MarthNotMirthun/asv-project-May_2026/lichifit_thruster.png

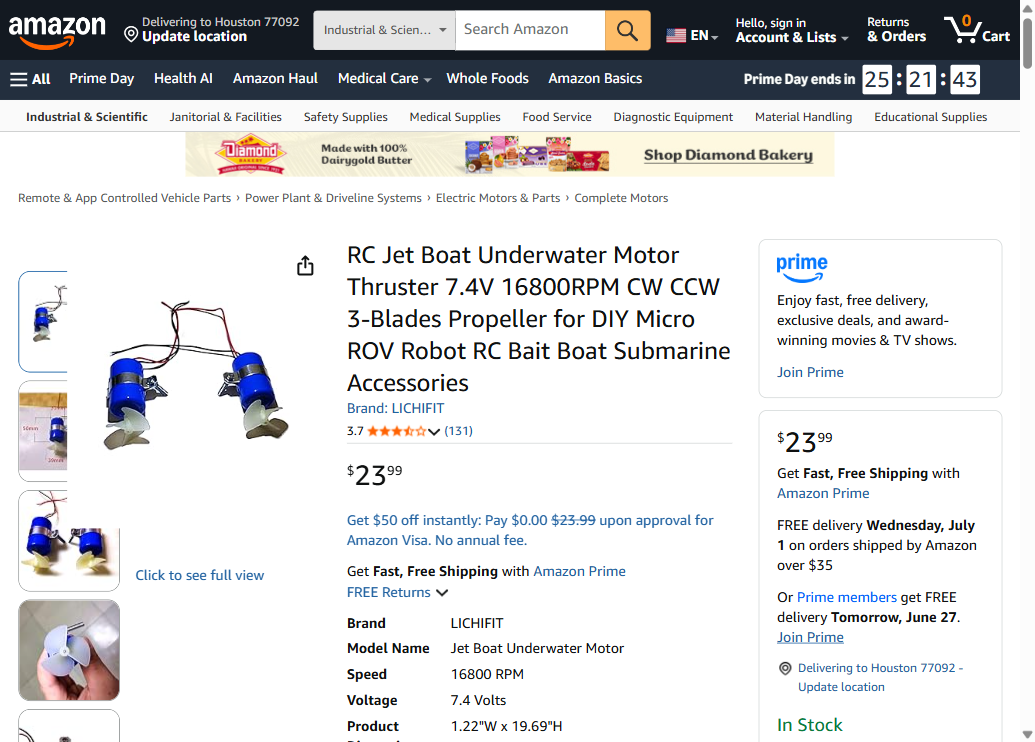
lichifit_thruster.png
