MarthNotMirthun/asv-project-May_2026/enclosure_b0dx781z3w.png

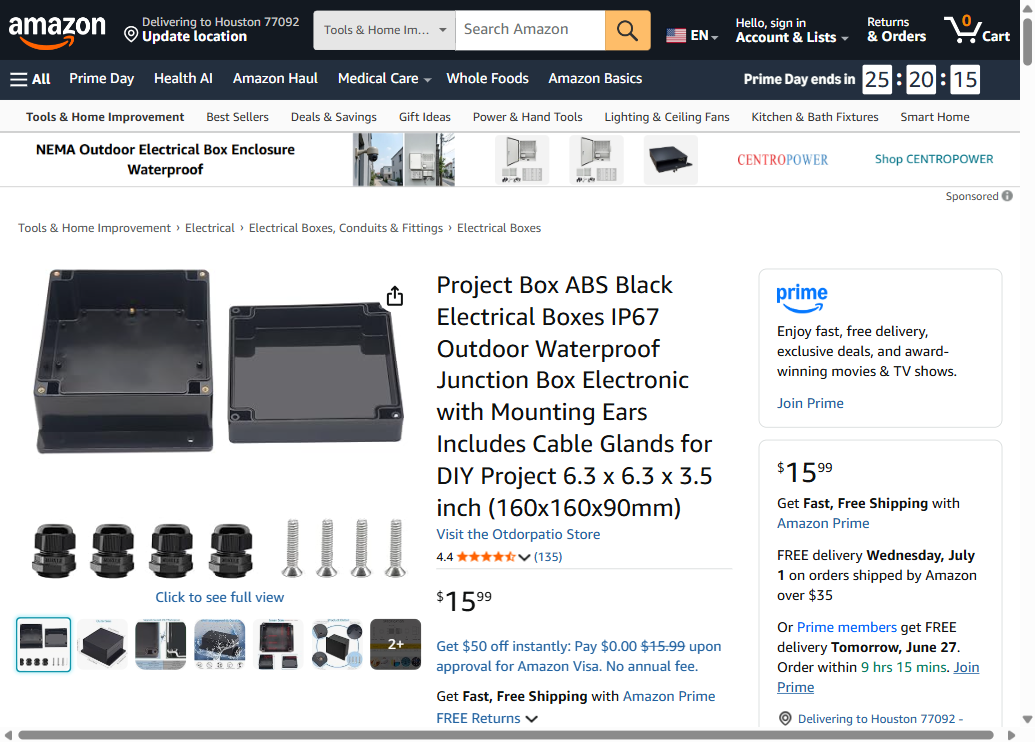
enclosure_b0dx781z3w.png
