MarthNotMirthun/asv-project-May_2026/irlz44n_search.png

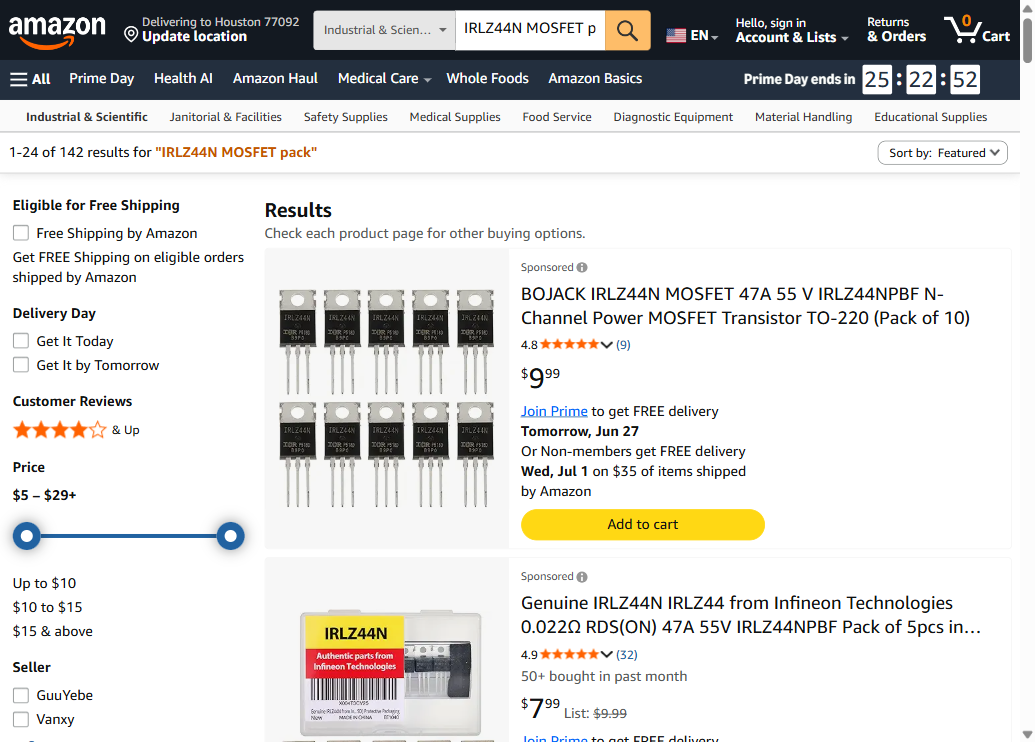
irlz44n_search.png
