MarthNotMirthun/asv-project-May_2026/mcp6022_amazon.png

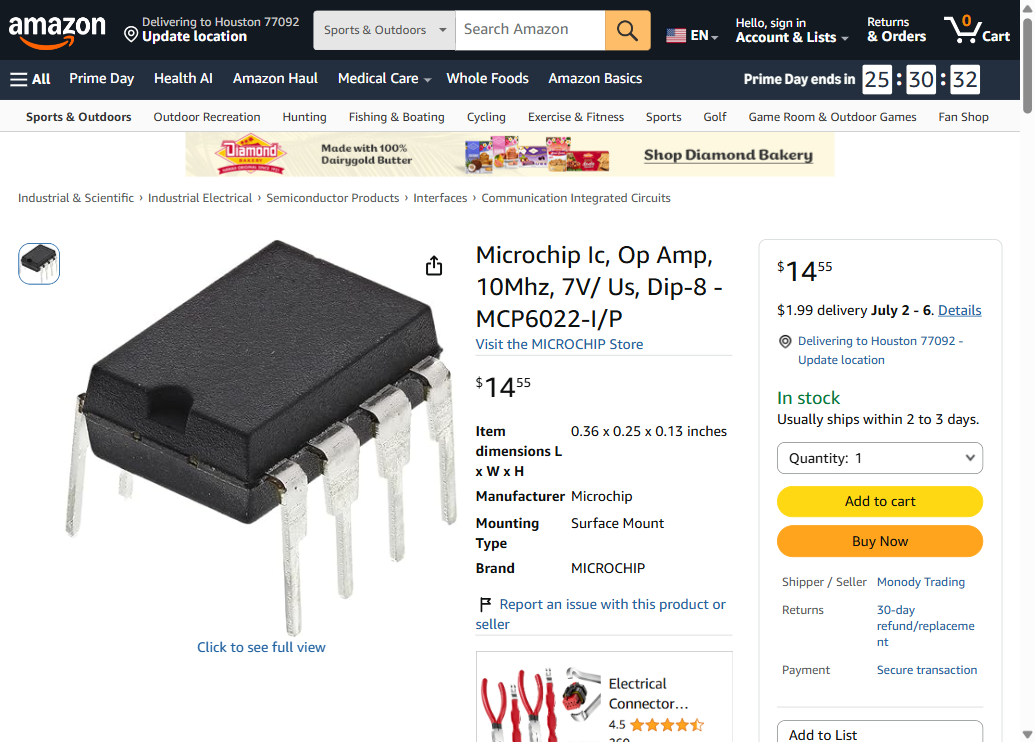
mcp6022_amazon.png
