MarthNotMirthun/asv-project-May_2026/mcp6022_prime.png

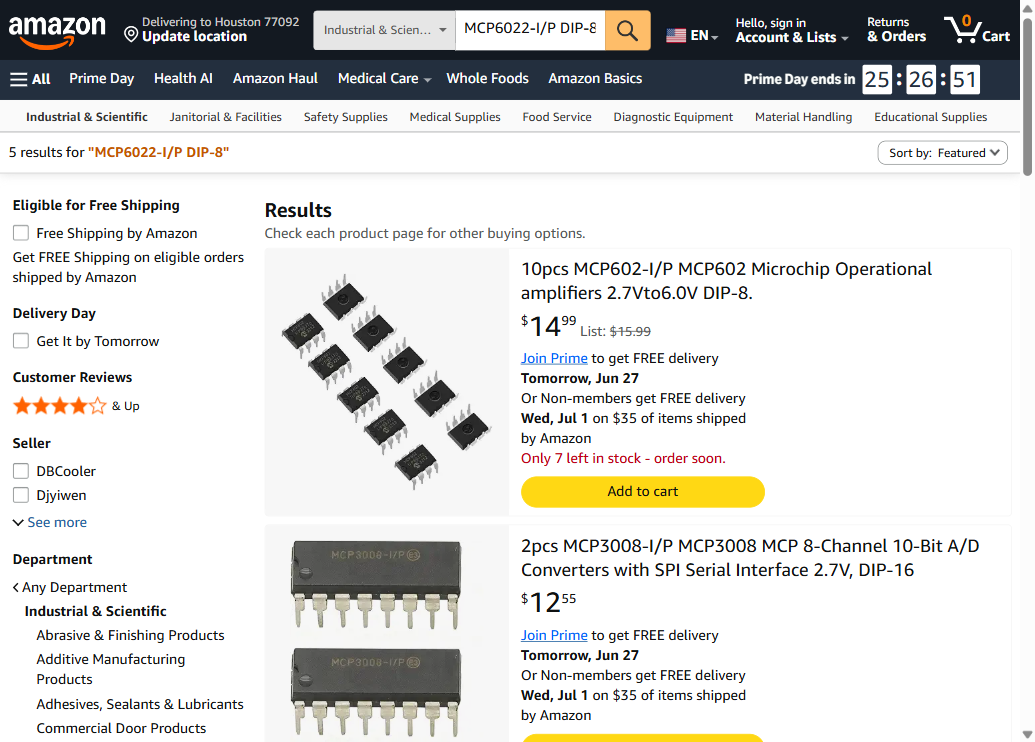
mcp6022_prime.png
