MarthNotMirthun/asv-project-May_2026/mcp6022_search2.png

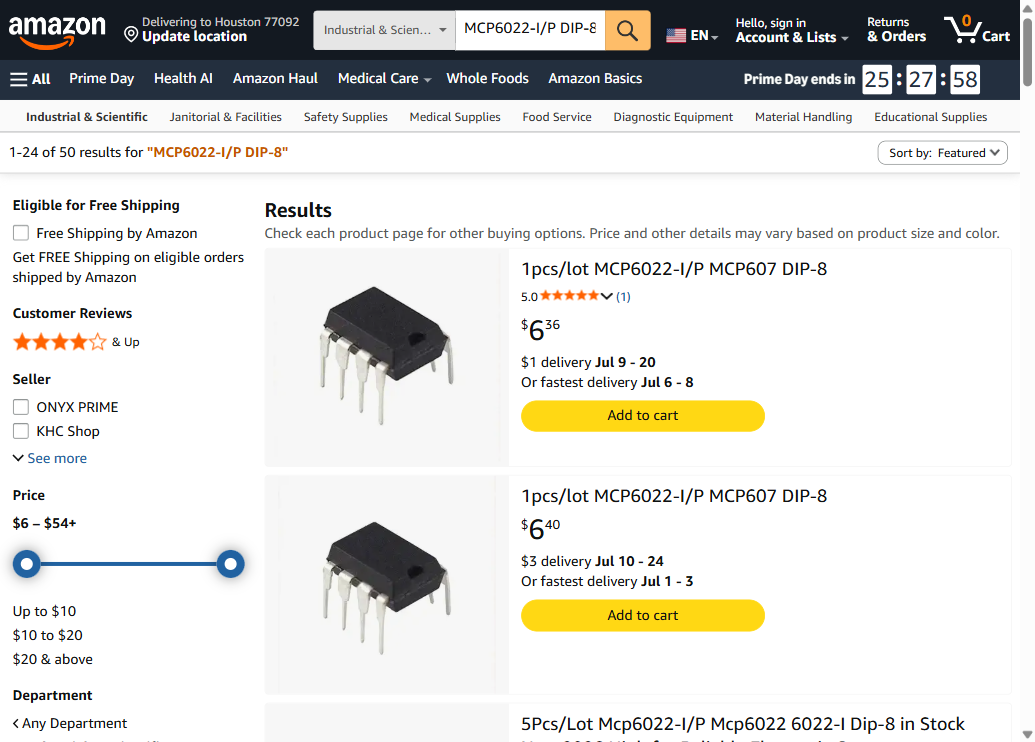
mcp6022_search2.png
