MarthNotMirthun/asv-project-May_2026/mcp6022_search.png

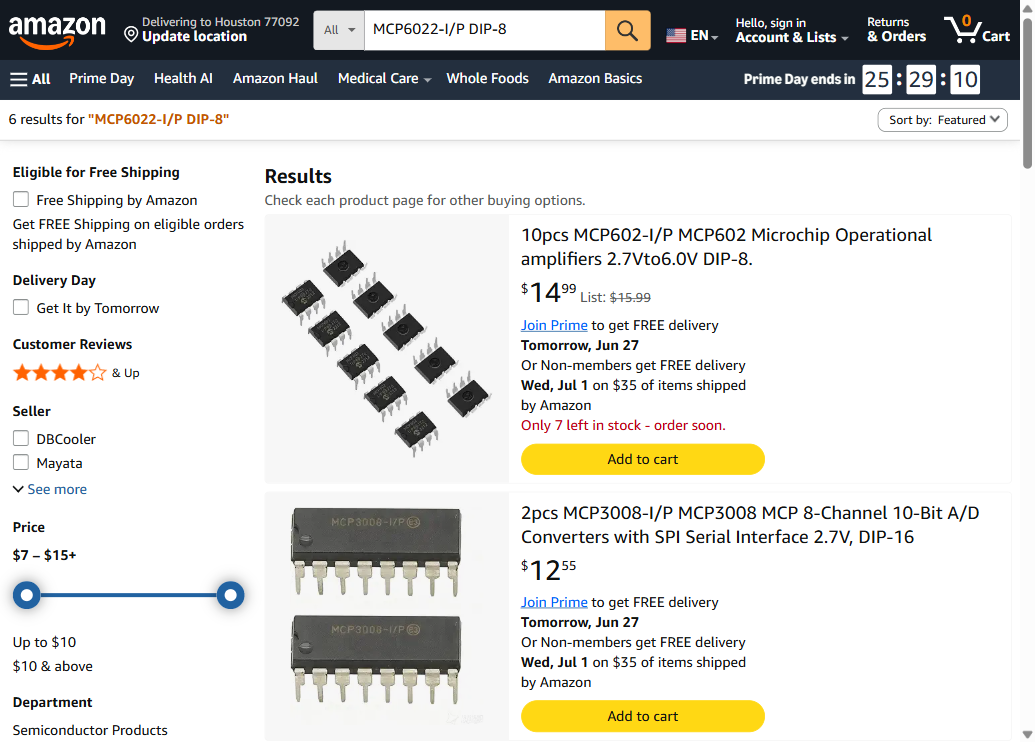
mcp6022_search.png
