MarthNotMirthun/asv-project-May_2026/(commit log)

2026-06-10 Fix uart_tx.cst: clk pin PULL_MODE UP->NONE (clock input needs no pull resistor)
2026-06-10 Fix FIR banks: replace initial blocks with synthesizable case-statement ROM; add fir_test_top timing wrapper
    [fir_filter_bank1.v, fir_filter_bank2.v]
2026-06-13 Week 3: FPGA pipeline verified - uart_tx, ADC, CIC, dual FIR banks
2026-06-16 Week 4: FC-5/FC-6 resolved - SNR-gradient ranging architecture, CLAUDE.md aligned
    - TRAJECTORY.md: Add CQ-1 (SNR plateau calibration queue); update Section 1 blocker
    note (FC-5/FC-6 confirmed resolved); update Section 4 matched filter spec to
    2109-sample 5ms reference chirps, corr_peak/snr as primary outputs, peak_lag
    diagnostic only
    - CLAUDE.md: Remove ToF/range_cm language from pipeline spec; update correlation
    window to 421,875 SPS (FC-3); rename [range_cm] packet bytes to [peak_lag]
    (wire format unchanged); update ROS topic /acoustic/range_m -> /acoustic/corr_snr;
    HOMING uses SNR gradient ascent; ARRIVED uses SNR_ARRIVED_THRESHOLD (CQ-1);
    Week 4 current, immediate tasks upd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
2026-06-16 Week 4: Dual matched filter correlators - SNR-gradient architecture per FC-5/FC-6
    - matched_filter_1.v: 34-38 kHz block correlator, 2109-tap, 48-bit accumulator
    - matched_filter_2.v: 42-46 kHz block correlator, identical architecture
    - Both: OTR window-OR (FC-2), CORR_SHIFT=16 scaling contract, 200Hz output
    - Testbenches: CHIRP_DETECT/NOISE_REJECT/OTR_FLAG/NO_XZ/SCALING/PEAK_LAG_ZERO all PASS
    - CLAUDE.md: corrected 800->2109 samples, 32/48->~4-6/48 HW mult, BSRAM totals
    - docs/progress.md: pipeline run logged with resource totals and latency
    [matched_filter_1.v, matched_filter_2.v, tb_matched_filter_1.v, tb_matched_filter_2.v]
2026-06-16 Week 4: Correct BSRAM resource accounting - depth constraint not capacity (12 blocks not 8, ~30% running total)
    - Depth constraint is binding: 1K×18 mode = 1024 locations/block
    2×1024=2048 < 2109 samples → 3 blocks per array, not 2
    - Corrected per-channel: 6 blocks (3 ref ROM + 3 window buffer)
    - Corrected total matched filter: 12 blocks (not 6 or 8)
    - Running total with FIR coefficients: ~14/46 blocks (~30%, not ~17%)
    - matched_filter_1.v, matched_filter_2.v: header comments corrected
    - CLAUDE.md: BSRAM table corrected; 4-array architecture documented
    - docs/progress.md: correction and forward budget outlook logged
    [matched_filter_1.v, matched_filter_2.v]
2026-06-17 Week 4: Layer A bench plan validated - two architecture blockers found (transducer bandwidth, MAX9814 audio-only)
    hw-validation confirmed FPGA PWM tone source is viable (FPGA clock divider
    exact to <0.15% at 40/36/44kHz). Two project-level blockers discovered:
    TCT40-16T/R are 40kHz-narrowband resonators - 34-38kHz and 42-46kHz chirp
    bands sit off-resonance. MAX9814 is a 20kHz audio preamp - cannot pass 40kHz.
    TRAJECTORY.md DL-1 updated with validated drive circuit specs and both blockers.
2026-06-17 Thruster downgrade 545 -> RF-370 (LICHIFIT): L298N-safe, add thrust gate
    545-class (~3.6A) structurally exceeds purchased L298N (2A/3A). Switch to
    LICHIFIT RF-370 kit (stall <1.8A, L298N PASS), drive ~9V via PWM duty cap,
    buy 2 kits (~$48) for spare-pair hedge. Add DL-2 with thrust-to-weight
    assessment and a gate: bench-verify >=150g/motor (200g target) before any
    thruster is epoxied into the hull (Week 5/6 boundary, pre-Week-6 mounting).
2026-06-17 Add PWM duty cycle ceiling requirement to hardware and firmware specs.
    Firmware must enforce 80% PWM max to protect thrusters from over-voltage due to
    L298N ~2V drop: at full duty cycle the 11.1V LiPo delivers ~9V effective,
    while at 80% the thrusters see ~9V safely. Baked this requirement into:
    - ESP32 #1 section (hardware constraint)
    - motor_driver_node spec (scaling requirement)
    - Week 6 timeline task
    - LOCKED DECISIONS table (design decision)
    This is NOT optional tuning — it is a firmware hard cap that must be enforced.
2026-06-18 Week 4: FC-7 confirmed (dual-channel gating mandatory), FC-8 added (egress maneuver), preamp AGC disqualification documented
    - FC-7: Added mandatory dual-channel gating specification (symmetric thresholding) to prevent false Buoy 2 detection during ARRIVED_1→SCAN_2 transition when cross-talk is +15 to +21 dB above genuine signal
    - FC-7: Unblocked peak_detector.v — now ready to build with dual-channel gating logic
    - FC-8 (NEW): Egress maneuver required after each ARRIVED_N state before starting SCAN_(N+1) to reduce vehicle-to-previous-buoy distance below dual-channel isolation margin
    - Preamp Hardware Contract: Replaced MAX9814 spec with mandatory fixed-gain op-amp contract; MAX9814 disqu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
2026-06-18 Week 4: peak_detector + packet_framer VALIDATED, docs updated - FC-7/FC-8 locked, pipeline status current
    peak_detector.v and packet_framer.v both verified with 12/12 sim checks passing.
    - Dual-channel RELATIVE gating (FC-7) confirmed superior to absolute thresholding
    - SNR proxy (8-bit), corr_peak (32-bit), peak_lag diagnostic (11-bit) outputs
    - 8-byte FSM packet format: [target_id][peak_lag_H/L][corr_peak_H/L][snr][XOR checksum][0xFF]
    - Commit hash 7ee44f0
    Architecture locked:
    - FC-7: Code-division beacon ID by sweep direction (up/down) in shared 38.5–41.5 kHz passband
    - FC-8: Egress maneuver required after each ARRIVED state for separation
    Next: FIR coefficient re-spin to 38.5–41.5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
2026-06-18 Week 4: FIR banks VALIDATED at 38.5-41.5kHz - all 9 FPGA modules verified, pipeline integration unblocked
    FIR Filter Banks (Jun 18):
    - Both fir_filter_bank1.v and fir_filter_bank2.v re-spun to 38.5-41.5 kHz passband per FC-7
    - Coefficients updated for single shared 40 kHz center frequency, 3 kHz bandwidth
    - Code-division beacon ID via sweep direction (up vs down), not frequency bands
    - 32-tap Hamming windowed-sinc, passband ripple <1dB, stopband confirmed
    - verilog-sim-runner: ALL PASS, no X/Z states
    Pipeline Status (all 9 modules):
    ✅ uart_tx (Jun 8)
    ✅ adc_interface (Jun 13)
    ✅ cic_decimator (Jun 10)
    ✅ fir_filter_bank1 (Jun 18)
    ✅ fir_filter_bank2 (Jun 18)
    ✅ matched_filter_1 (Jun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
2026-06-26 Week 5: Component audit firmware requirements and hardware build notes added
    - motor_driver_node: mandatory stall-current protection (cut PWM if >1.5A/ch for >100ms,
    resume at 50% after 500ms) — LICHIFIT RF-370 stall = 5-8.6A, destroys L298N at sustained stall
    - ESP32 ENA/ENB: must use LEDC hardware PWM channels (GPIO25/26), not GPIO toggle; software
    toggle can slip above 80% duty under micro-ROS + IMU + ultrasonic interrupt pressure
    - collision_safety_node: ESTOP threshold raised 25cm -> 30cm; JSN-SR04T blind zone is 25cm,
    25cm threshold risks missing obstacles in sensor dead zone
    - Preamp gain: revised to x100 / 40dB (Rf=9.1kΩ or 10kΩ, Rg=1kΩ per stage); x196 clips
    ADC at 5.1m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
2026-06-29 Week 5 close / Week 6 start: definitive component audit complete, timeline revised for 43-day sprint to August 10 demo
    - docs/component_audit_june28.md: full signal chain audit with datasheet citations; MCP6022 confirmed over MCP6002 (GBW math), IRLZ44N verified at 40kHz switching, enclosure B0DX781Z3W 160x160x90mm confirmed, TCT40-16T/R bandwidth conditional on Layer A bench sweep
    - docs/TRAJECTORY.md: Section 4 replaced with revised 6-week plan (Weeks 6-11); DL-5 added (MCP6022-I/P selected, full rolloff math); Week 6 day-by-day breakdown
    - CLAUDE.md: status updated to Week 5 CLOSED / Week 6 starts Jun 29; In Transit populated (LICHIFIT x2, enclosure, IRLZ44N); Not Yet Ordered updated with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
2026-06-30 Week 6: Top-level pipeline integration complete
    Wire all 9 verified FPGA modules into top_level.v: adc_interface ->
    cic_decimator -> fir_filter_bank1/2 (parallel) -> matched_filter_1/2
    (parallel) -> peak_detector -> packet_framer -> uart_tx.
    Fix packet_framer corr_peak packing (FIX-B3): was sending raw [15:0]
    which wraps and inverts the FC-6 homing gradient at close range; now
    sends saturating (corr_peak>>6) clamped to 16-bit, preserving
    monotonic SNR gradient through final approach.
    Add top_level.cst merged constraint file covering all external pins.
    Write tb_top_level.v end-to-end testbench (synthetic 40kHz chirp).
    Full pipeline sim: ALL PASS — 8-byte UART packet decoded, checksum
    veri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
    [matched_filter_1.v, matched_filter_2.v, packet_framer.v, tb_top_level.v, top_level.v]
2026-06-30 Week 6: ESP32 vehicle firmware skeleton
    micro-ROS node for the ASV vehicle controller (ESP32 #1):
    - MPU-6050 I2C driver (GPIO21/22), publishes /imu/data at 100Hz
    - L298N motor control via LEDC PWM GPIO25/26 (ENA/ENB),
    subscribes /cmd_vel Twist, enforces 80% duty cap (DL-1)
    - JSN-SR04T sonar (30cm ESTOP, 1-second clear hysteresis),
    publishes /collision/range_cm at 10Hz
    - Stall protection: software current estimate >1.5A for >100ms
    cuts PWM to 0, resumes at 50% after 500ms (DL-4)
    - cmd_vel watchdog: zero motors if no command for >500ms
    - RELIABLE QoS for /cmd_vel, BEST_EFFORT for sensor streams
    - Wheel velocity estimate published on /wheel/velocity at 50Hz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
    [motor_control.h, mpu6050_driver.h, sonar_driver.h, vehicle_firmware.ino]
2026-06-30 Week 6: Buoy ESP32 firmware - LFM chirp generation
    Standalone (no micro-ROS) chirp generator for both acoustic beacons.
    Single codebase with compile-time BUOY_ID flag selects sweep direction
    per FC-7 code-division beacon ID: Buoy 1 UP-sweep 38.5->41.5kHz, Buoy 2
    DOWN-sweep 41.5->38.5kHz, both at 5ms chirp / 20Hz repeat. LEDC-driven
    discrete-step square wave approximates the LFM ramp (validated approach
    per DL-1 addendum) into 3x IRLZ44N-gated TCT40-16T transducers at 120deg
    spacing for 360deg coverage.
2026-06-30 Week 6: ROS 2 fpga_uart_node complete
    Bridges FPGA UART packets (/dev/ttyAMA0 @ 115200) to ROS 2. Validates
    checksum (XOR bytes 0-5) and 0xFF terminator, sliding-window resync
    handles partial packets at startup. Publishes /acoustic/corr_snr
    (Float32, primary SNR-gradient homing signal per FC-6), /acoustic/
    peak_lag (UInt16, diagnostic only per FC-5), and /acoustic/target_id
    (UInt8). BEST_EFFORT QoS depth 10 per CLAUDE.md sensor-stream policy.
2026-06-30 Week 6: Gowin synthesis checklist for top_level.v
    Step-by-step Gowin EDA project setup for GW2AR-18C, source/constraint
    file list, manual clock constraint (27MHz/37.037ns), what to record from
    the timing/resource reports (WNS, TNS, LUT%, DSP blocks, BSRAM blocks),
    pass/fail criteria against CLAUDE.md's pre-synthesis estimates, and a
    negative-WNS triage procedure pointing at the matched filter accumulator
    as the most likely critical path.
2026-06-30 Week 6: Structural and wiring diagrams added
    Four SVG reference diagrams for the ASV build:
    - vehicle_top_view.svg — catamaran top-down (pontoons, cross members, enclosure, mast, thrusters, sonar)
    - vehicle_side_view.svg — side profile with waterline, mast height 250-300mm, cable routing
    - buoy_assembly.svg — pool-noodle/ABS-box beacon assembly, 3× TCT40-16T at 120°, Buoy 1/2 callouts
    - wiring_overview.svg — color-coded block diagram (11.1V/5V/3.3V/analog/I2C domains), all signal interfaces
    All dimensions from CLAUDE.md/component audit: 4" Sch40 PVC 700mm pontoons, 400mm beam,
    Otdorpatio 160×160×90mm enclosure, mast 25-30cm above waterline.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
2026-06-30 Week 6: Fix vehicle top view — add deck platform, widen cross members to 1-inch PVC scale
2026-06-30 Week 6: Update side profile diagram and add hull construction guide
2026-06-30 Week 6: Add hull construction flow diagram (visual 10-phase step-by-step)
2026-07-01 Week 6: Hull design analysis + verified Home Depot materials list
    Cost/reusability-optimized foam-and-deck hull design (pool noodles on
    PVC core rods, plywood deck, dowel mast) replacing the 4in PVC baseline,
    with buoyancy math and a Home Depot shopping list verified via live
    search (SKUs, pricing, substitution notes for out-of-stock items).
2026-07-01 Week 6: Rebuild hull construction guide and diagrams for foam-and-deck design
    Replaces the 4in PVC / 700mm build plan with the cost/reusability-optimized
    foam-and-deck design (pool noodle pontoons on PVC core rods, plywood deck,
    dowel mast, all-mechanical fasteners). Removes both 24hr epoxy cure gates
    from the schedule since the new design has no structural adhesive.
2026-07-01 Week 6: Fix deck-to-pontoon fastener (zip-tie lashing, not pipe straps)
    A rigid 1/2in galvanized pipe strap can only clamp bare pipe, but the
    noodle-and-core-rod pontoons are foam-wrapped along their full length
    by the time the deck goes on -- there was no bare rod left for a strap
    to grab. Replaces the pipe-strap fastener with zip-tie lashing through
    small drilled holes in the deck, which wraps directly over the foam
    bundle. Updates the guide, both dimension diagrams, the construction
    flow diagram, and the shopping list/cost totals accordingly (drops the
    now-unnecessary pipe strap line item, ~$4 cheaper).
2026-07-02 Week 6: All ROS 2 nodes complete - acoustic homing state machine, motor driver, collision safety, EKF dead reckoning, mission monitor, telemetry
    Builds all six remaining ROS 2 nodes (vehicle_control, acoustic_homing,
    telemetry packages) plus uart_rx.v, the FPGA's inbound Pi->FPGA config
    path. All 10 fpga/sim testbenches pass with zero regressions.
    Corrects the /cmd_vel wiring topology: since esp32/vehicle_firmware
    already subscribes directly to /cmd_vel with its own onboard ESTOP and
    watchdog, acoustic_homing_node now publishes /cmd_vel_raw, gated through
    collision_safety_node -> /cmd_vel_safe -> motor_driver_node -> /cmd_vel,
    so the Pi-side safety layer is actually in the loop instead of r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
    [tb_uart_rx.v]
